Huzaifa-Rahim-Malik/Outdoor-Autonomous-Vehicle/images/3D_Electronics.png

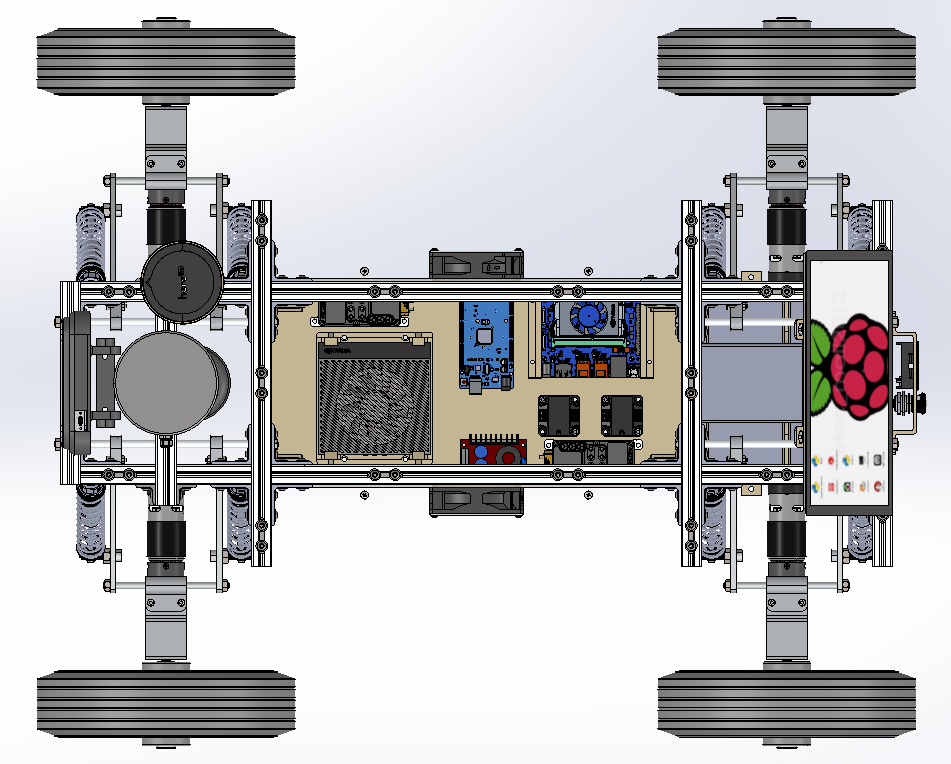
images/3D_Electronics.png
