Huzaifa-Rahim-Malik/Outdoor-Autonomous-Vehicle/docs/BOM_Electronics.xlsx

Sheet: Outdoor_Vehicle_PCB_BOM
Description | Designator | Manufacturer Name | Manufacturer Part Number | Supplier | Supplier Part Number | Value | Tolerance | Rating | Quantity
0.1 µF ±20% 50V Ceramic Capacitor Z5U Radial | C1, C5, C6, C7, C8, C9, C10, C11, C12 | KEMET | C322C104M5U5TA | Digikey | 399-4331-ND | 0.1 µF | ±20% | 50V | 9
CAP ALUM 470UF 20% 50V RADIAL TH | C2, C4 | Nichicon | UHE1H471MHD3 | Digikey | 493-1615-ND | 470 µF | ±20% | 50 V | 2
CAP CER 0.33UF 50V X7R RADIAL | C3 | TDK Corporation | FA24X7R1H334KNU06 | Digikey | 445-180638-1-ND | 0.33 µF | ±10% | 50V | 1
FUSE BLOCK CARTRIDGE PCB | F1 | LITTELFUSE | 0PTF0078P | Digikey | F6094-ND | - | - | - | 1
FUSE BLOCK CARTRIDGE PCB | Receptor F1 | LITTELFUSE | 0PTF0078P | Digikey | F6094-ND | - | - | - | 1
IC REG LINEAR 5V 1.5A TO220-3 | IC1 | Texas Instruments | LM7805CT/NOPB | Digikey | 296-47192-ND | 5-35V | - | 1.5A | 1
Connector: DC supply; socket; male; XT90; 40A; 500V; PIN: 2; straight | J1 | Amass | XT90PW-M | TEM Electronics Component | XT90PW-M | Male | - | - | 1
CONN HEADER VERT 2POS 2.54MM | J2 | Molex | 0022272021 | Digikey | WM4111-ND | - | - | - | 1
Connector: DC supply; socket; female; XT90; 40A; 500V; PIN: 2; THT | J3, J4 | Amass | XT90PW-F | TEM Electronics Component | XT90PW-F | Female | - | - | 2
TERM BINDING POST M2.5 1 PIN PCB | J5, J6, J7, J8, J9, J10 | Keystone Electronics | 8730 | Digikey | 36-8730-ND | - | - | - | 6
LED GREEN DIFFUSED 3MM ROUND T/H | LED1, LED2, LED3, LED4 | Wurth Elektronik | 151031VS06000 | Digikey | 732-5008-ND | 2.2V | - | 20mA | 4
MOSFET P-CH 55V 74A TO220AB | Q1 | Infineon | IRF4905PBF | Digikey | IRF4905PBF-ND | - | - | 74A | 1
RES 10K OHM 5% 1/4W AXIAL | R1, R2 | Stackpole Electronics Inc | CF14JT10K0 | Digikey | CF14JT10K0TR-ND | 10 kOhms | ±5% | 0.25W, 1/4W | 2
RES 1K OHM 5% 1/4W AXIAL | R3, R4, R5, R6, R7, R8, R9, R10, R11 | Stackpole Electronics Inc | CF14JT1K00 | Digikey | CF14JT1K00TR-ND | 1 kOhms | ±5% | 0.25W, 1/4W | 9
Smart High-Side Power Switch | U1, U2, U3, U4, U5 | Infineon Technologies | BTS500051LUAAUMA1 | Digikey | 448-BTS500051LUAAUMA1TR-ND | 3.1V ~ 28V |  | 65A | 5

Sheet: Outdoor_Vehicle_Electronics_BOM
S# | Item Name | Specification /Part Number | QTY
1 | Fan Tubeaxial 12VDC Square - 92mm L x 92mm H Ball 102.6 CFM (2.87m³/min) 4 Wire Leads | Model: AFC0912D-AF00 Brand: Delta Electronics Voltage Rated: 12VDC Size / Dimension: Square - 92mm L x 92mm H | 2
2 | 92mm Sq Fan Filter/Screen Aluminium, Stainless Steel | Model: AFM-92M Fits Fan Size: 92mm Sq | 2
3 | LED Panel Indicator Green Clear 5V ~ 28V 20mA Wire Leads - 5.5" (139.70mm) | Model: PML50GFVW Voltage: 5-28V Current: 20mA | 1
4 | 50A ON/OFF Disconnect Battery Switch | - | 1
5 | VOLTMETER 4.5-30VDC LED PNL MNT | Model: 575 Voltage: 4.5-30V | 1
6 | DHT22 Humidity, Temperature Sensor Gravity Platform Evaluation Expansion Board | Model: SEN0137 Voltage: 5V | 1
7 | 6A BEC / Voltage Regulator | SKU Part No: 3119-4444-0006 Type: Voltage Regulator Brand: goBilda Output Voltage: 5V, 6V, 8.4V, 12V Output Current: 6A Continuous (7A Burst) Input Voltage (@8.4V Output):10–24V | 2
8 | Pololu 12V, 4.5A Step-Down Voltage Regulator | Model: D42V55F12 Input Voltage: 12V-60V Current: 4.5A (max) Output Voltage: 12V (fixed) | 1
9 | Pololu 5V, 2.5A Step-Down Voltage Regulator | Model: D24V25F5 Input Voltage: 6V-38V Current: 2.5A (max) Output Voltage: 5V (fixed) | 1
10 | Pololu 12V, 2.2A Step-Down Voltage Regulator | Model: D24V22F12 Input Voltage: 12.7-36V Current: 2.2A (max) Output Voltage: 12V (fixed) | 1
11 | 150W 10-32V In 12-35V Out 6A DC-DC Step Up Boost Converter Power Supply Module | Model: EM-POWER-0018 Input Voltage: 10-32V Output Voltage: 12V-35V Continuously Output Current: 6A (MAX) | 1
12 | NVIDIA® Jetson Orin™ Nano Super Developer Kit | Model: Jetson Orin™ Nano Super Developer Kit | 1
13 | NVIDIA® Jetson AGX Orin™ 64GB Developer Kit | Model: NVIDIA® Jetson AGX Orin™ 64GB Developer Kit | 1
14 | ARDUINO MEGA2560 | Model: A000067 | 1
15 | 5303 Series Saturn Planetary Gear Motor (50.9:1 Ratio, 24mm Length 8mm REX™ Shaft, 360 RPM, 3.3 - 5V Encoder) | Model: 5303 Series Saturn Planetary Gear Motor Motor Size: RS-560 Motor Type : Brushed DC Nominal Voltage: 24VDC Output Shaft: 8mm REX™, 23.5mm Length Nominal Gear Ratio:50.9:1 | 4
16 | 2x40A Motor Controller | Motor Controller Manufacturer: go bilda Voltage Range: 9-30V Continuous Current per Channel: 40A Burst Current per Channel: 50A Signal Voltage: 3.3 - 5V Channels: 2 | 2
17 | Zeee 4S 12000mAh 14.8V 12C Lipo Battery w/XT90 | - | 4
18 | Non-Slip Battery Strap 400mm | - | 3
19 | UGREEN 10238 4K UHD DP TO HDMI CABLE 1M | - | 1
20 | SWITCH ROCKER SPST 12A 250VAC | - | 1
21 | 10.4inch QLED Quantum Dot Display, Capacitive Touch, High Brightness, 1600×720, Optical Bonding Toughened Glass Panel, HDMI Interface |  | 1
 |  | Part No:10.4HP-CAPQLED (EU) Brand: Wave share Resolution: 1600 x 7200 Size: 10.4 inches Display Interface: HDMI Touch: Yes Viewing angle: 178 degrees
22 | 0.3M/1FT 22AWG USB Type C Male Pigtail,5V 3A Singe USB C to 2 Pin Bare Wire Open End Cable Cord | - | 2
23 | BNTECHGO 12 Gauge Silicone Wire Kit: Ultra Flexible, 20 ft | - | 1
24 | BNTECHGO 22 Gauge Silicone Wire Kit: Ultra Flexible, 100 Feet | - | 1
25 | 2901 Series Shock Mount (1-1) - 2 Pack | SKU: 2901-0001-0001 Brand: go bilda Material: Aluminum | 8
26 | 1516 Series 8mm REX Standoff (M4 x 0.7mm Threads, 80mm Length) | SKU: 1516-4008-0800 Brand: go bilda Material: Aluminum | 4
27 | Big Bore Shock (190mm Length, Black) | SKU: 2900-0190-0001 Brand: go bilda Length:190mm | 8
28 | Rubber Solid-Tread Flat-Free Wheel Side-Mount Hub with Ball Bearing, 10" Diameter x 2" Wide | Wheel Type: Flat Free Wheel/Tread Material: Rubber Wheel Diameter: 10" Wheel Width: 2 1/2" | 4
