Huzaifa-Rahim-Malik/Outdoor-Autonomous-Vehicle/docs/Schematics.pdf

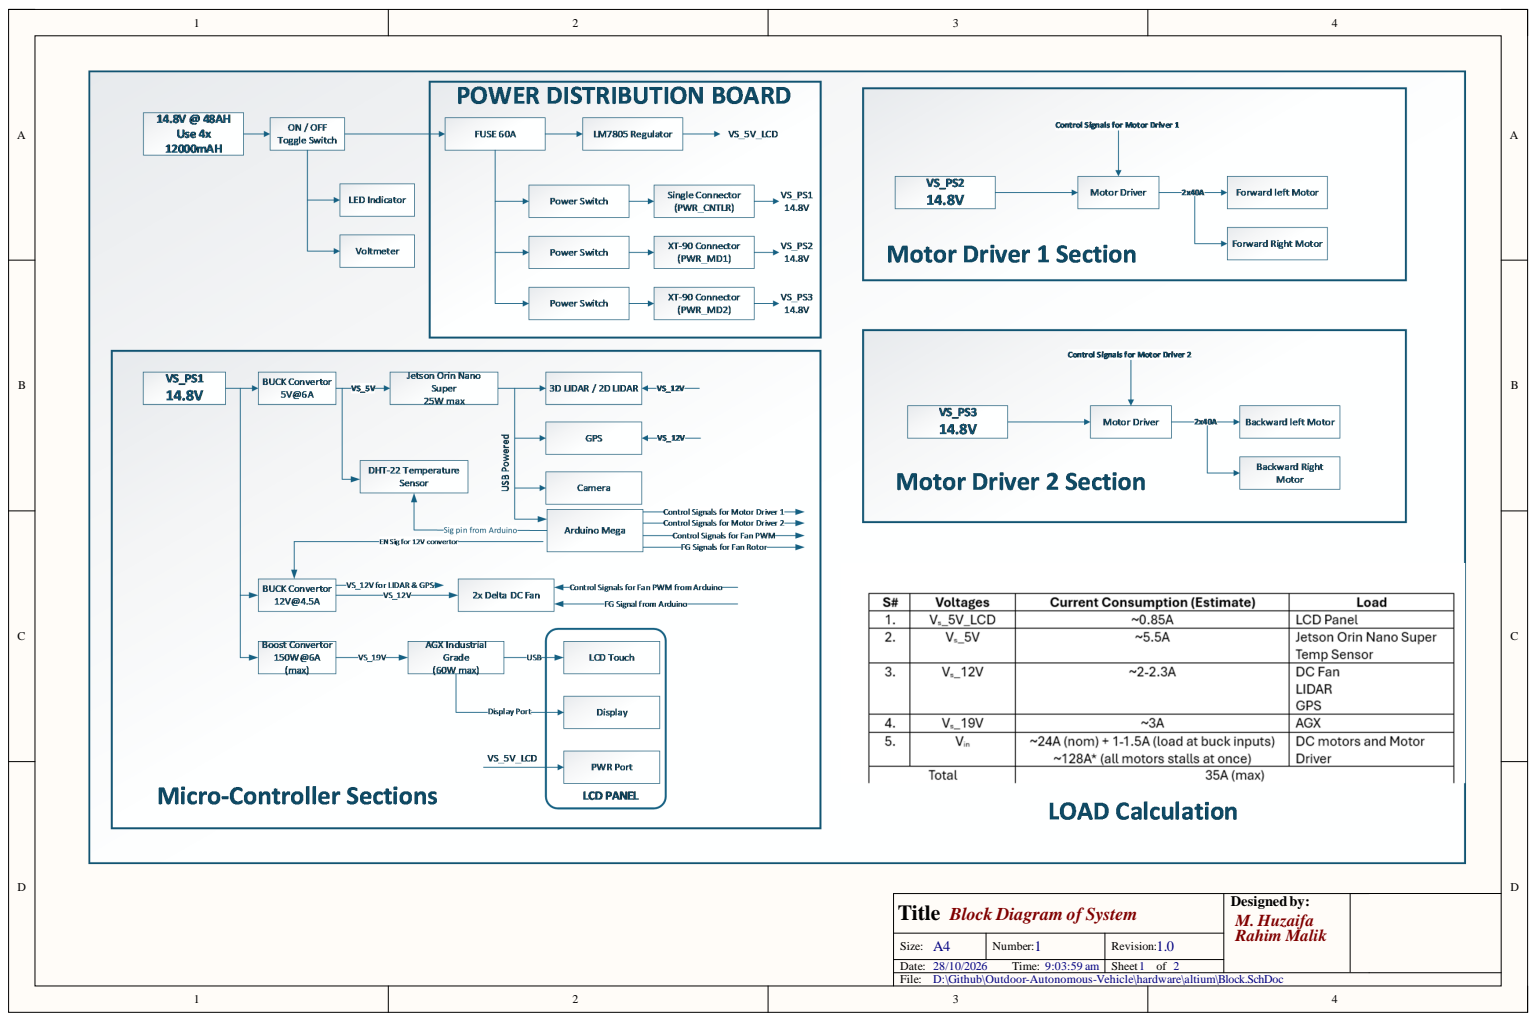
[picture p15: page 1]

Block Diagram of System

D:\Github\Outdoor-Autonomous-Vehicle\hardware\altium\Block.SchDoc

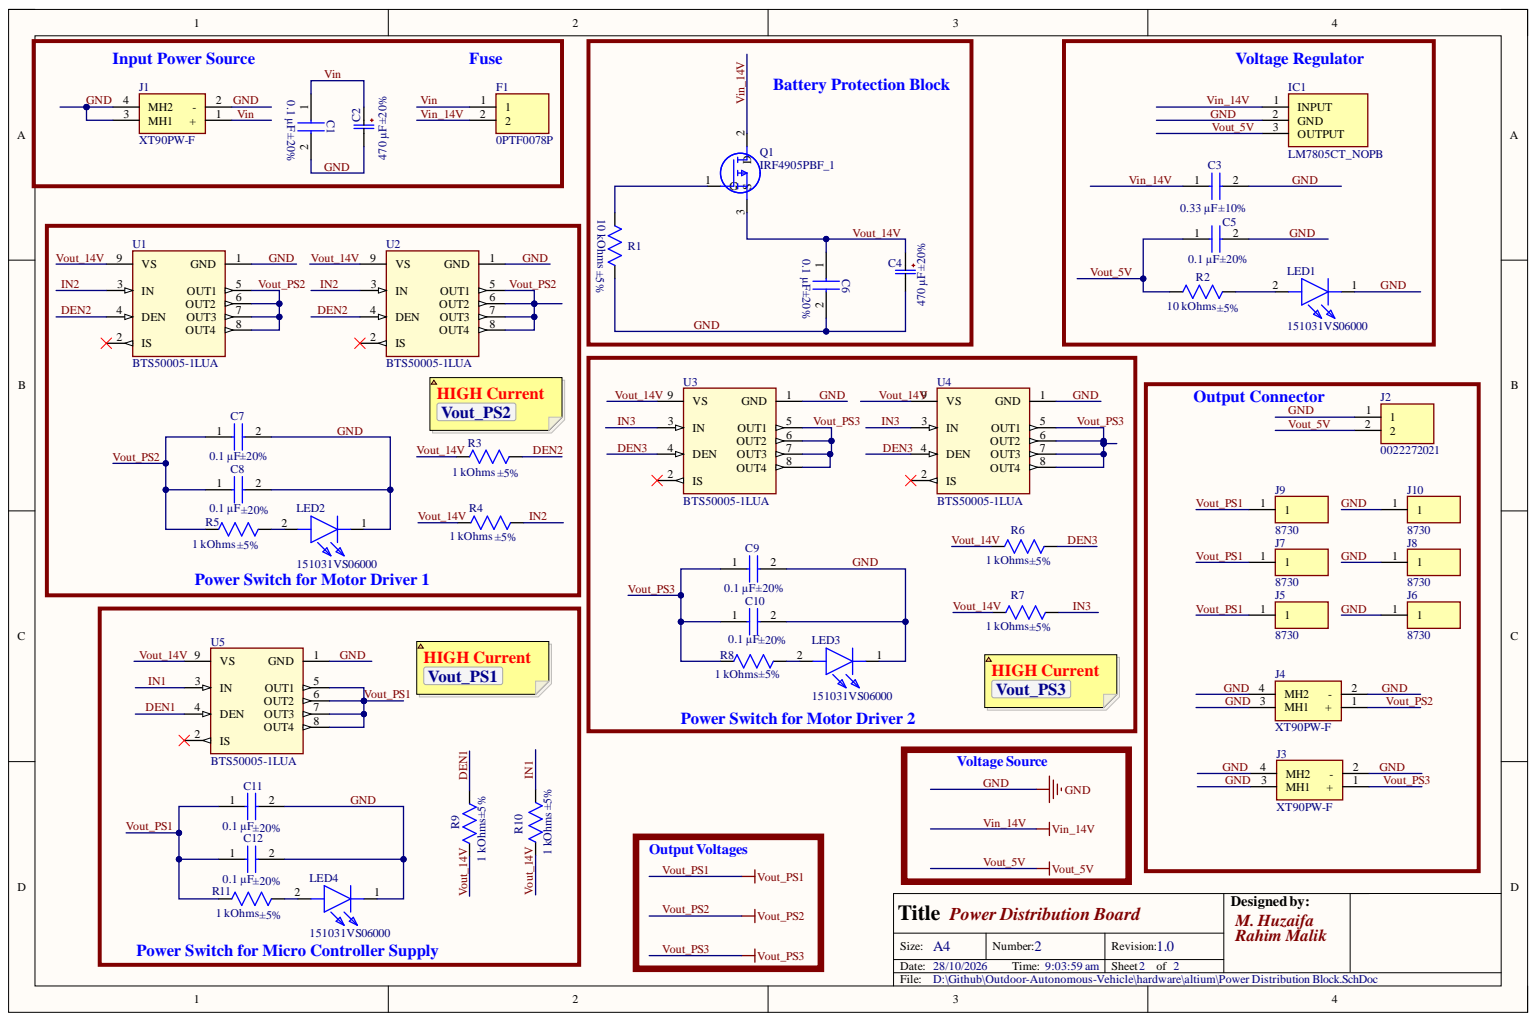
[picture p16: page 2]

Power Switch for Motor Driver 1

Power Switch for Motor Driver 2

D:\Github\Outdoor-Autonomous-Vehicle\hardware\altium\Power Distribution Block.SchDoc

Power Switch for Micro Controller Supply

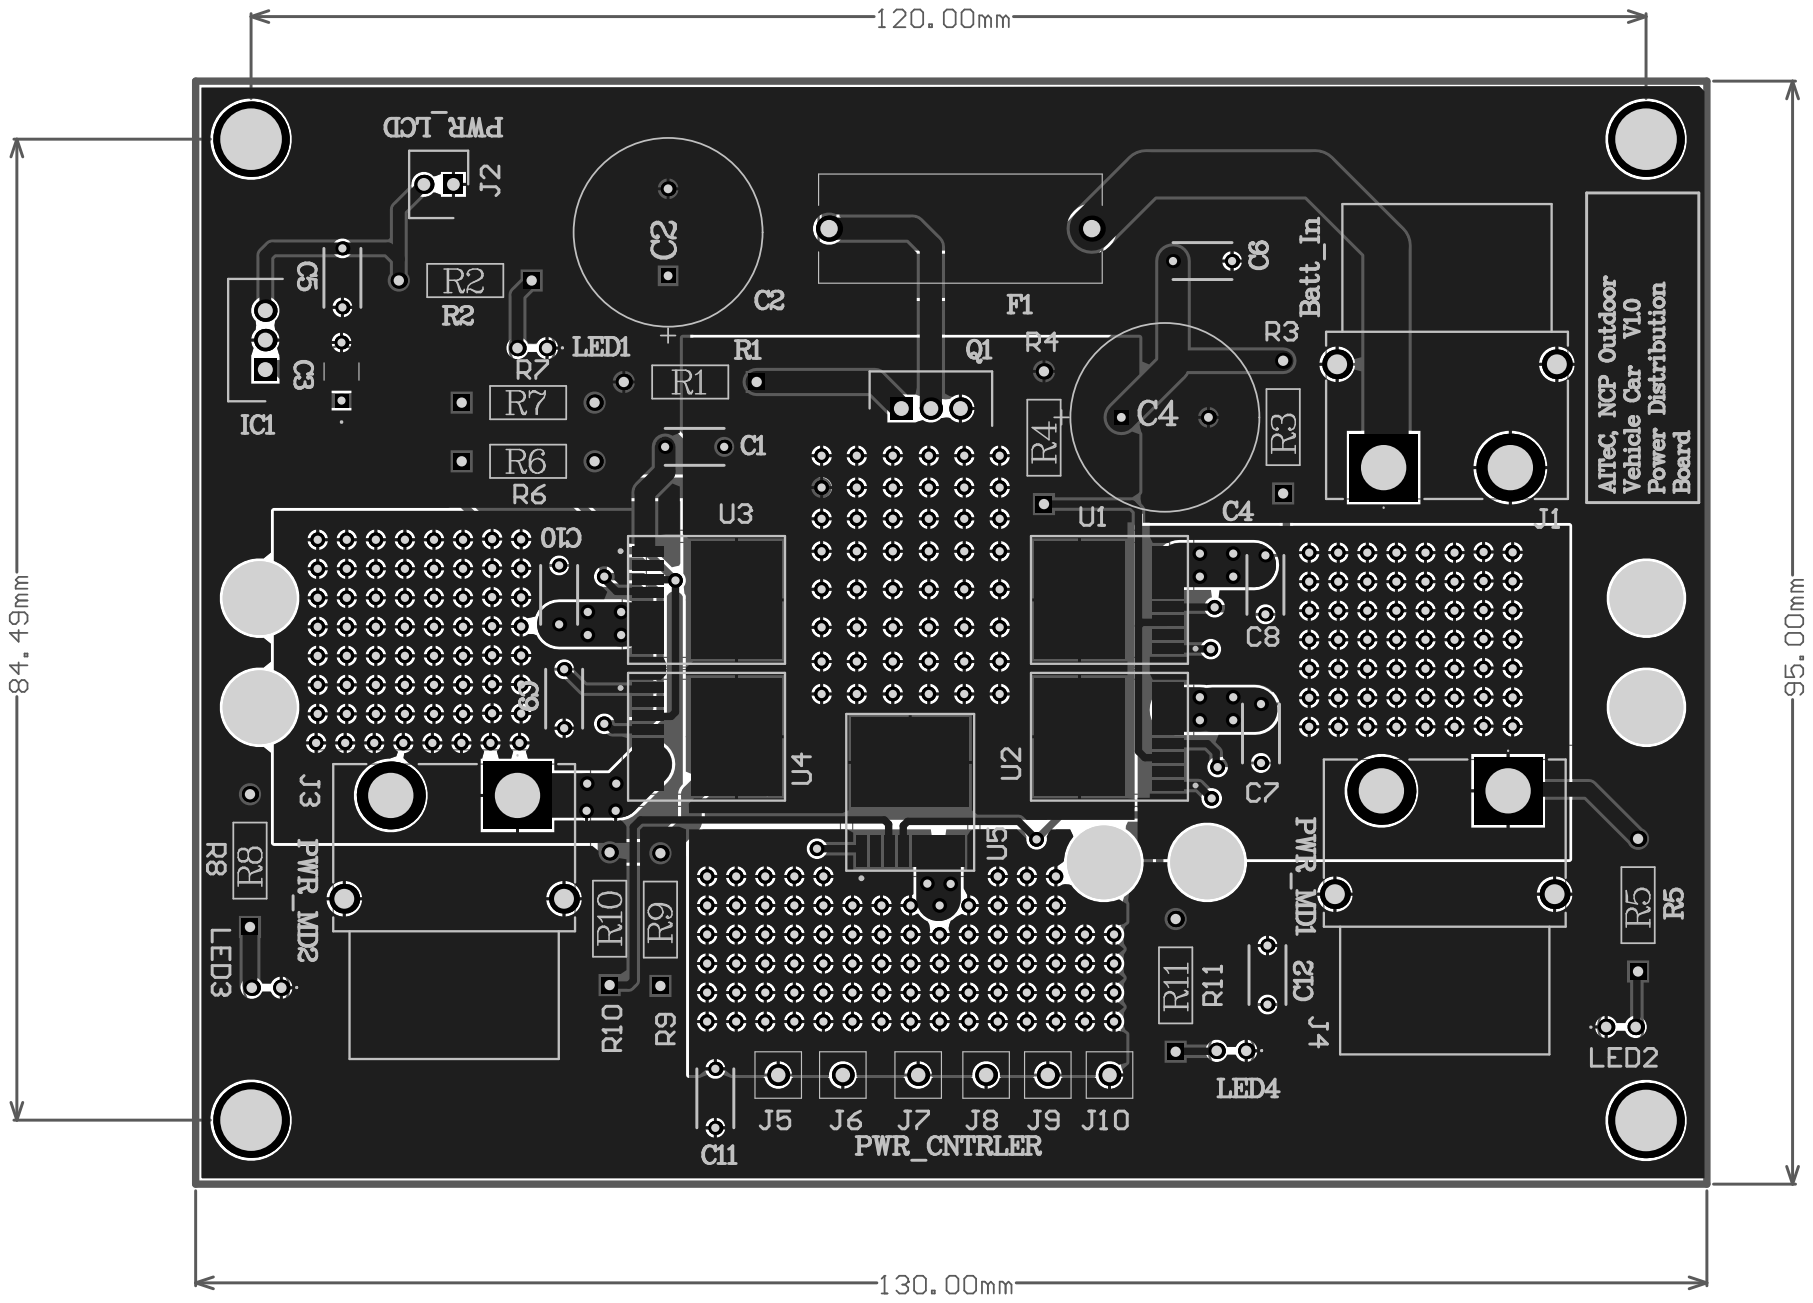
[picture p17: page 3]

Description | Designator | Manufacturer Name | Manufacturer Part Number | Supplier | Supplier Part Number | Value | Tolerance | Rating | Quantity
0.1µF±20%50VCeramic Capacitor Z5URadial | C1, C5, C6, C7, C8, C9, C10, C11, C12 | KEMET | C322C104M5U5TA | Digikey | 399-4331-ND | 0.1µF | ±20% | 50V | 9
CAPALUM470UF20%50VRADIALTH | C2, C4 | Nichicon | UHE1H471MHD3 | Digikey | 493-1615-ND | 470µF | ±20% | 50V | 2
CAPCER0.33UF50VX7RRADIAL | C3 | TDKCorporation | FA24X7R1H334KNU06 | Digikey | 445-180638-1-ND | 0.33µF | ±10% | 50V | 1
FUSEBLOCKCARTRIDGEPCB | F1 | LITTELFUSE | 0PTF0078P | Digikey | F6094-ND | | | | 1
ICREGLINEAR5V1.5ATO220-3 | IC1 | Texas Instruments | LM7805CT/NOPB | Digikey | 296-47192-ND | 5-35V | | 1.5A | 1
Connector: DCsupply; socket; male; XT90; 40A; 500V; PIN: 2; straight | J1 | Amass | XT90PW-M | TEM Electronics Component | XT90PW-M | Male | | | 1
CONN HEADERVERT2POS2.54MM | J2 | Molex | 0022272021 | Digikey | WM4111-ND | | | | 1
Connector: DCsupply; socket; female; XT90; 40A; 500V; PIN: 2; THT | J3, J4 | Amass | XT90PW-F | TEM Electronics Component | XT90PW-F | Female | | | 2
TERMBINDINGPOSTM2.51PIN PCB | J5, J6, J7, J8, J9, J10 | KeystoneElectronics | 8730 | 36-8730-ND | Digikey | | | | 6
LEDGREEN DIFFUSED3MMROUND T/H | LED1, LED2, LED3, LED4 | Wurth Elektronik | 151031VS06000 | Digikey | 732-5008-ND | 2.2V | | 20mA | 4
MOSFETP-CH55V74ATO220AB | Q1 | Infineon | IRF4905PBF | Digikey | IRF4905PBF-ND | | | 74A | 1
RES10KOHM5%1/4WAXIAL | R1, R2 | StackpoleElectronics Inc | CF14JT10K0 | Digikey | CF14JT10K0TR-ND | 10kOhms | ±5% | 0.25W,1/4 W | 2
RES1KOHM5%1/4WAXIAL | R3, R4, R5, R6, R7, R8, R9, R10, R11 | StackpoleElectronics Inc | CF14JT1K00 | Digikey | CF14JT1K00TR-ND | 1kOhms | ±5% | 0.25W, 1/4W | 9
Smart High-SidePower Switch | U1, U2, U3, U4, U5 | Infineon Technologies | BTS500051LUAAUMA1 | Digikey | 448-BTS500051LUAAUMA1TR-ND | 3.1V~28V | | 65A | 5
