Huzaifa-Rahim-Malik/Outdoor-Autonomous-Vehicle/(list of files, drawings)

Other design files:
hardware/altium/Block.SchDoc
hardware/altium/final_PCB.PcbDoc
hardware/altium/Outdoor_Vehicle.PrjPcb
hardware/altium/PcbLib1.PcbLib
hardware/altium/Power Distribution Block.SchDoc
hardware/altium/Schlib1.SchLib
