Huzaifa-Rahim-Malik/Outdoor-Autonomous-Vehicle/(commit log)

2026-10-06 Initial commit: Outdoor Vehicle power distribution & protection board (Altium, schematics, BOM, DRC)
    [BOM.xlsx, Block.SchDoc, Components_Link_List.xlsx, Outdoor_Vehicle.PrjPcb, PcbLib1.PcbLib, Power Distribution Block.SchDoc, Schlib1.SchLib, final_PCB.PcbDoc]
2026-10-06 Update files
    [BOM.xlsx, BOM_Electronics.xlsx, Block.SchDoc, Components_Link_List.xlsx, Outdoor_Vehicle.PrjPcb, Power Distribution Block.SchDoc, Protection Circuit.ms14, final_PCB.step]
2026-10-07 Update file
    [BOM_Electronics.xlsx, Block.SchDoc, Outdoor_Vehicle.PrjPcb, PcbLib1.PcbLib, Power Distribution Block.SchDoc, Protection Circuit.ms14, Schlib1.SchLib, final_PCB.PcbDoc]
